ediiloupatty/buoy/perhitungan_des/chart_akurasi.png

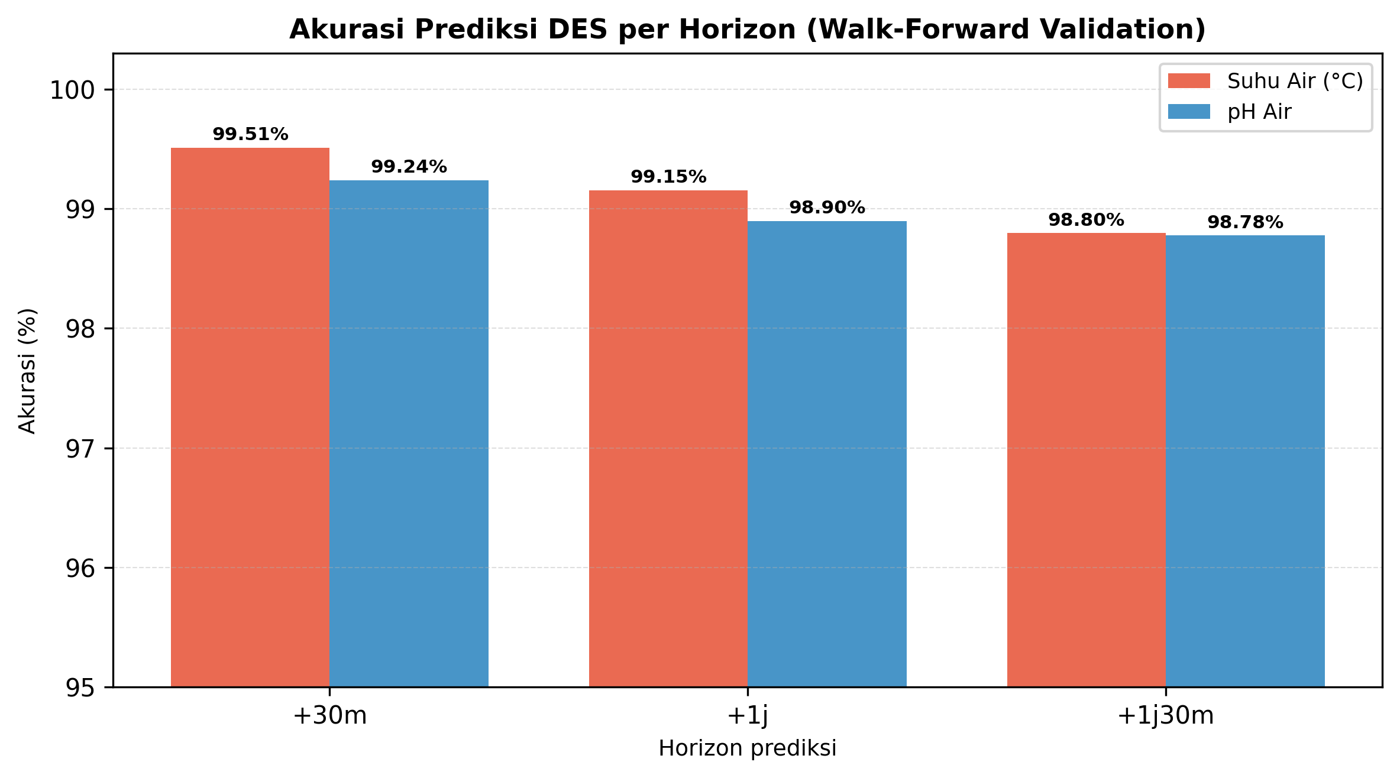
perhitungan_des/chart_akurasi.png
