ediiloupatty/buoy/perhitungan_des/chart_ph.png

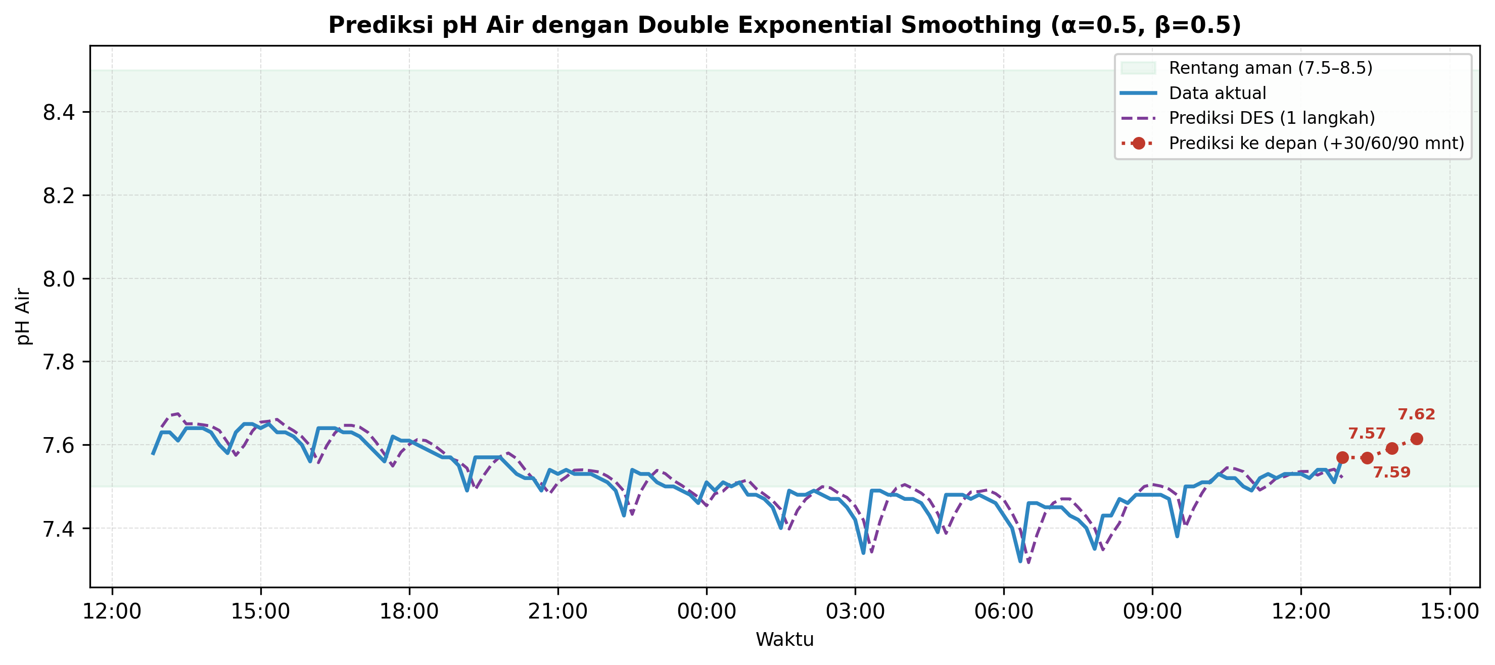
perhitungan_des/chart_ph.png
