ediiloupatty/buoy/perhitungan_des/chart_suhu.png

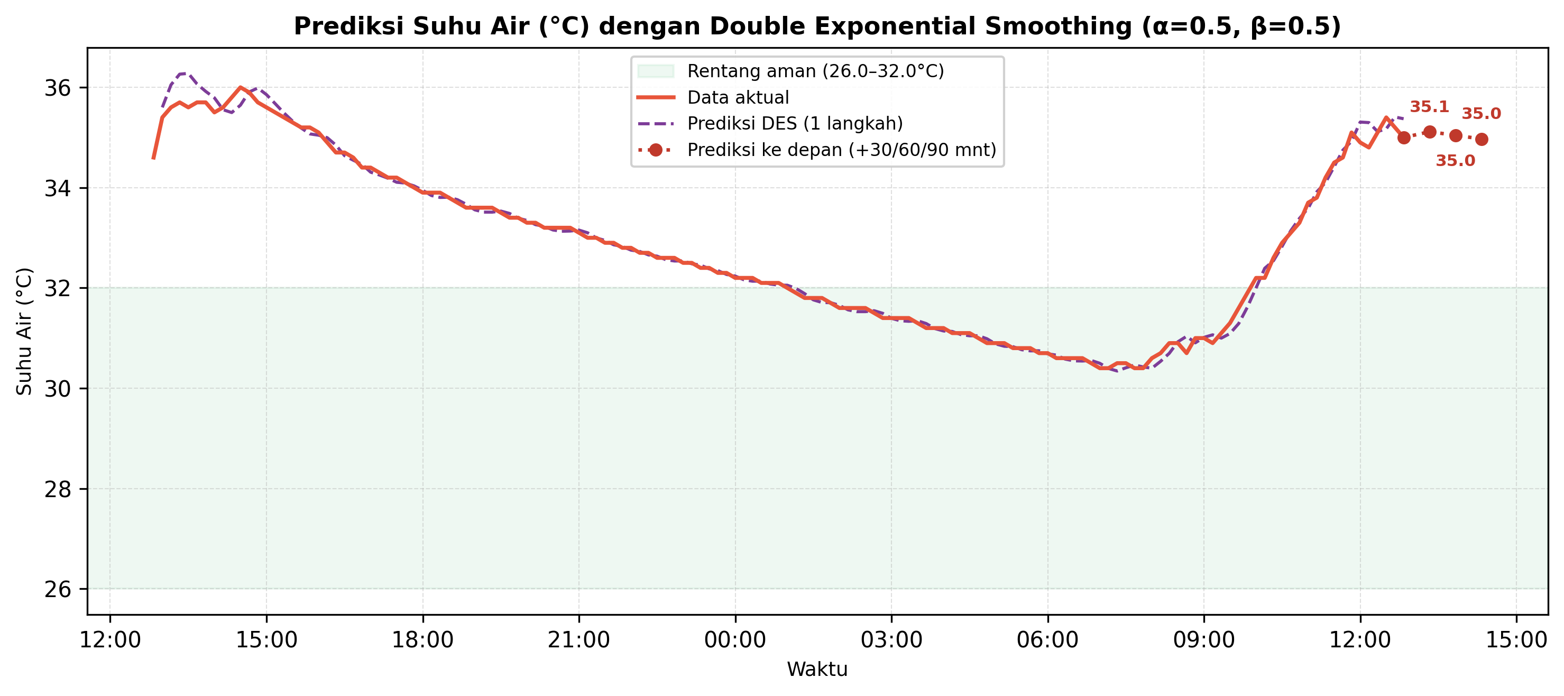
perhitungan_des/chart_suhu.png
