ediiloupatty/buoy/perhitungan_des/tuning_heatmap.png

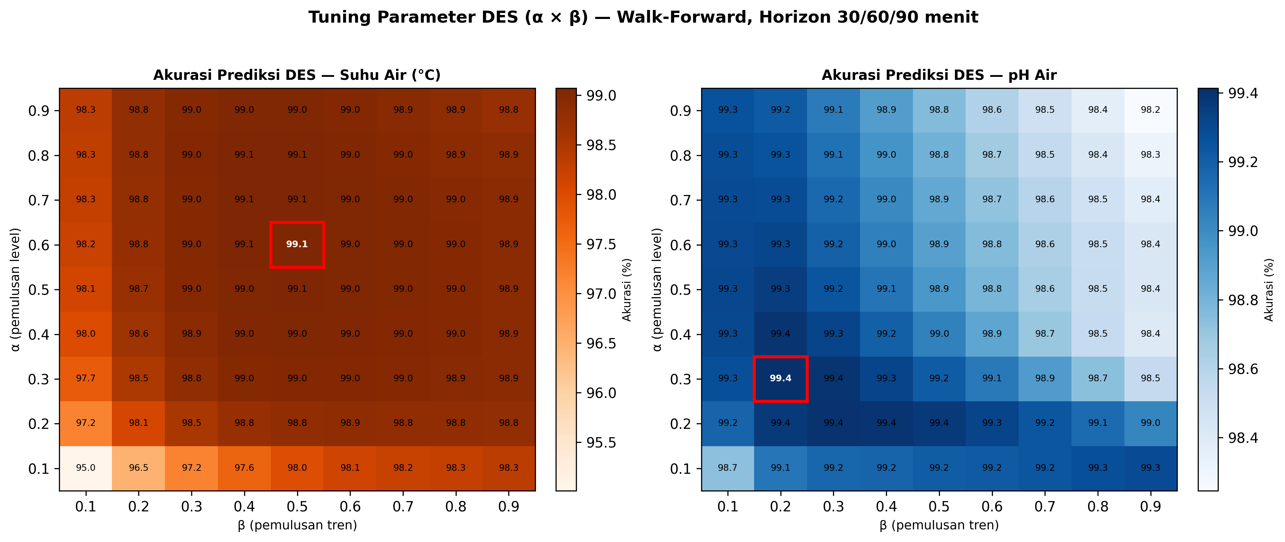
perhitungan_des/tuning_heatmap.png
