ediiloupatty/buoy/(commit log)

2026-04-18 Update web refresh and sensor reading intervals to 5 seconds
2026-04-18 Update pin labels from D to P for ESP32 dev v4
2026-04-29 perf: batch Firebase live writes into single JSON request
    - Replace 4 separate Firebase.setFloat/setInt/setString calls with 1 setJSON call
    - Reduces HTTP overhead by ~73% (from ~530MB/mo to ~145MB/mo)
    - Remove redundant status_kekeruhan from live data (derived client-side)
    - Update README documentation to reflect new data structure
    [Config.h, Sensors.cpp, final_project.ino]
2026-04-29 feat: add NTP time sync and organize Firebase history by date/time
    - Add NTP synchronization (pool.ntp.org) with WIT timezone (UTC+9)
    - History path now uses readable format: /history/2026-04-29/21:10:00
    - Fallback to millis() path if NTP sync fails (data safety)
    - Remove redundant status_kekeruhan from history data
    - Local web dashboard now shows real clock time instead of seconds-since-boot
    - Update README with new data structure docs and Flutter examples
    [final_project.ino]
2026-04-29 refactor: replace Firebase history with Supabase PostgreSQL for ML training
    - Remove Firebase /history/ writes (10min interval)
    - Add Supabase HTTP POST for history data (tabel sensor_readings)
    - Add sendToSupabase() function with NTP timestamp
    - Add Supabase URL/key placeholders in Config.h
    - Firebase now only handles live data (10sec) for Flutter app
    - Supabase handles tabular data for ML training pipeline
    - Update README with new dual-database architecture docs
    - Include SQL schema, table example, and Python ML training code
    [Config.h, final_project.ino]
2026-04-30 Refactor: Migrate history to Firebase RTDB & remove sensor smoothing
2026-04-30 Fix: Adjust NTP timezone offset to WIB (UTC+7)
    [final_project.ino]
2026-05-02 feat(sensors): add interactive pH calibration with NVS persistence and temperature compensation
    - Add Serial calibration commands (CAL4, CAL7, CALSAVE, CALINFO) for interactive two-point pH calibration
    - Persist calibration constants (m, b) to ESP32 NVS flash memory — values survive reboot
    - Add Nernst-based temperature compensation using DS18B20 data
    - Replace single-shot ADC read with trimmed mean filter (10 samples, discard 4 outliers)
    - Preserve backward-compatible readPH() signature alongside new readPH(tempC) overload
    - Read temperature before pH in main loop to ensure valid compensation data
    [Sensors.cpp, Sensors.h, final_project.ino]
2026-05-02 docs: add comprehensive pH sensor calibration guide (KALIBRASI.md)
    - Step-by-step calibration procedure (7 steps) with expected Serial output
    - Calibration theory: two-point linear, Nernst compensation, trimmed mean filter
    - Validation methodology with error percentage calculation
    - Troubleshooting table and recalibration schedule
2026-05-02 feat: migrate to SIM800L GPRS + deep sleep architecture (v2.0)
    - Replace WiFi with SIM800L GPRS via AT Commands
    - Implement ESP32 deep sleep with 2-minute wake interval
    - Remove local web server (redundant with Firebase dashboard)
    - Switch from Firebase SDK to REST API over HTTPS
    - Add RTC memory persistence for boot count and threshold values
    - Add calibration mode detection at boot (5-second serial window)
    - Add SISTEM.md comprehensive system architecture documentation
    - Update README.md to reflect v2.0 architecture
    - Energy analysis: surplus +2.36 Wh/day with deep sleep (solar sustainable)
    [Config.h, final_project.ino]
2026-05-02 refactor: separate pH calibration into standalone sketch
    - Remove calibration mode from main firmware (final_project.ino)
    - Create dedicated kalibrasi/kalibrasi.ino for pH calibration
    - Main firmware now focuses purely on: sensor → SIM800L → deep sleep
    - Both programs share the same NVS namespace ('ph_cal')
    - Added READ command in calibration tool for continuous sensor monitoring
2026-05-03 feat: add WiFi test mode for deep sleep testing
    - Add USE_WIFI conditional compilation flag in Config.h
    - WiFi credentials: SSID='No Internet Connection', PASS='Loupatty143'
    - WiFi mode uses HTTPClient + WiFiClientSecure for Firebase REST API
    - WiFi mode uses NTP (pool.ntp.org) for timestamp instead of AT+CCLK
    - All SIM800L code preserved in #else block (zero production impact)
    - Deep sleep, sensor, and RTC memory logic completely unchanged
    - To switch back to SIM800L: comment out '#define USE_WIFI' in Config.h
2026-05-07 fix(sim800l): turunkan baud rate ke 9600 dan tambah PWRKEY toggle
    - Ubah SIM_BAUD dari 115200 ke 9600 (default SIM800L, lebih stabil)
    - Tambah SIM_PWRKEY pin 5 di Config.h untuk hardware reset
    - Refactor initSIM800L(): tambah powerCycleSIM800L() dengan PWRKEY pulse
    - Tambah auto-retry: coba PWRKEY toggle jika modem tidak respons
    - Tambah AT+CMEE=2 untuk verbose error reporting saat debugging
    - Perbaiki validasi CPIN dengan 5x retry (SIM card butuh waktu init)
    - Tambah deteksi SIM PIN lock dan NO SIM sebagai error spesifik
    - Perluas timeout registrasi jaringan dari 30s ke 45s
    - Tambah info operator (AT+COPS?) di serial output untuk debug
    [Config.h, final_project.ino]
2026-05-07 fix(sim800l): ganti PWRKEY dengan RST pin (module board SIM800L)
    - Rename SIM_PWRKEY → SIM_RST di Config.h (module board pakai RST bukan PWRKEY)
    - RST active LOW: pulse LOW 200ms sudah cukup untuk reset (bukan 1200ms)
    - Rename powerCycleSIM800L() → resetSIM800L() agar lebih deskriptif
    - Update semua referensi dan pesan serial yang menyebut PWRKEY ke RST
    [Config.h, final_project.ino]
2026-05-07 fix(code-review): perbaiki 4 isu dari hasil review kode
    - Fix komentar step 3 di initSIM800L: PWRKEY → RST
    - Fix pesan error voltage: 3.7-4.2V → 4.6-5.2V (SIM800L V2)
    - Tambah header X-HTTP-Method-Override: PUT untuk sendFirebasePUT()
    karena SIM800L AT+HTTPACTION tidak support native PUT (hanya GET/POST/HEAD)
    - Perjelas komentar SLEEP_DURATION_US bahwa ini DEBUG MODE
    - Tambah dokumentasi lengkap workaround PUT di komentar sendFirebasePUT()
    [Config.h, final_project.ino]
2026-05-07 feat(diagnostic): tambah SIM800L diagnostic sketch
    - Auto-detect baud rate (coba 9600, 115200, 57600, 38400, 19200, 4800)
    - RST reset otomatis jika modem tidak respons di semua baud rate
    - Cek SIM card, sinyal, operator, dan registrasi jaringan
    - Info modem lengkap (model, firmware, IMEI)
    - Mode manual aktif setelah diagnostic — bisa ketik AT command langsung
    - Output Serial Monitor terstruktur dan mudah dibaca
2026-05-10 feat(sensor): upgrade pH calibration to 3-point piecewise linear
2026-05-10 fix: add missing ADC_FLOAT_LOW and ADC_FLOAT_HIGH constants to kalibrasi.ino
    [kalibrasi.ino]
2026-05-10 chore: update default pH calibration values to user measurements
2026-05-16 feat: migrate to 2-point pH calibration & update WiFi credentials
2026-05-16 feat: Add two-point linear calibration for Turbidity sensor
2026-05-26 feat(pump): auto-cycle 2-channel pump system (FILLING → WAITING → DRAINING)
    Migrasi firmware utama dari deep-sleep model ke always-on state machine
    yang menjalankan siklus pompa otomatis tanpa intervensi user.
    - Tambah pin relay PUMP_FILL_PIN (GPIO 25) & PUMP_DRAIN_PIN (GPIO 26)
    - State machine 3 fase: FILLING (60s) → WAITING (15s debug/15m prod) → DRAINING (40s)
    - Interlock safety: pompa 1 & 2 tidak pernah ON bersamaan
    - Mode debug/production lewat PUMP_DEBUG_MODE
    - Telemetry tiap 30s + auto-reconnect WiFi
    - Path baru /smart_buoy/pump_status untuk mobile app monitoring
    - Retry HTTP 2x untuk handshake yang gagal di jaringan lambat
    - Timestamp NTP diubah ke milliseconds (uint64_t) su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
2026-05-26 feat(sensor): hardcode turbidity 2-point + add diagnostic & accuracy testing tools
    Turbidity calibration:
    - Pindah dari NVS-based ke hardcoded constants (TURB_V_CLEAR=3.30, TURB_V_TURBID=2.26)
    - Nonaktifkan command TCAL0/TCAL400/TCALSAVE (cuma print pesan kalau dipanggil)
    - Sinkron antara Sensors.cpp dan kalibrasi.ino
    Tools baru di kalibrasi.ino:
    - CAL1 <pH> — kalibrasi 1-titik pH tanpa buffer (pertahankan slope, geser offset)
    - DIAG / DIAGTURB — sampling ADC mentah 8 detik untuk deteksi stray voltage,
    ground loop, dan riak AC dari kincir/pompa (lengkap dgn interpretasi otomatis)
    - ERRPH / ERRTURB / ERRTEMP <ref> — uji akurasi 5x pengukuran dengan tabel
    hasil (err absolut & relati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
2026-05-26 docs: tambah catatan kalibrasi, laporan uji akurasi & utilitas pendukung
    - NOTE_KALIBRASI.md: catatan resep kalibrasi DIY (turbidity & pH) + lessons learned
    - Pengujian_Akurasi_Sensor.docx: laporan tabel uji akurasi sensor (ERRPH/ERRTURB/ERRTEMP)
    - debug_turbidity/debug_turbidity.ino: sketch ESP32 standalone untuk debug sensor turbidity
    - generate_doc.py: script generator dokumentasi laporan uji
2026-06-03 feat: finalisasi scope suhu+pH, tuning siklus pompa & tambah materi perhitungan
    [data_dummy.csv, data_history.csv, data_history_24jam.csv, data_history_firebase.csv, history_2026-05-31.csv]
2026-06-07 feat: arsitektur 2-node LoRa (buoy TX + receiver gateway) + web interface + turbidity via ADS1115
    - buoy_transmitter: baca sensor + pompa + kirim LoRa (tanpa WiFi)
    - receiver_gateway: terima LoRa -> NTP -> Firebase + web monitoring di IP ESP (port 80, auto-refresh /data)
    - turbidity pindah dari ADC internal ESP32 ke ADS1115 (I2C, 16-bit) + perintah TURBV untuk re-kalibrasi
    - lora_diag: sketch diagnostik SPI Ra-02 (baca REG_VERSION)
    - Config.h per-node di-gitignore (kredensial tidak ikut)
2026-07-02 feat: node aktuator kapur + pompa (LoRa RX) beserta debug transmitter
    - node_kapur: ESP8266 + servo dispenser, dedup doseId, sync saat boot,
    clamp openMs 5 dtk, servo bergerak kecepatan penuh
    - node_pompa: ESP8266 + relay cooling, state-based + fail-safe OFF
    - debug_node_kapur_tx / debug_node_pompa_tx / debug_buoy_tx: mock TX
    untuk pengujian tiap node
    - buoy_transmitter & receiver_gateway: kirim perintah CMD ke node aktuator
    - tools/bebaskan-port.cmd + PANDUAN_NODE_AKTUATOR.pdf
    [buoy_transmitter.ino, debug_buoy_tx.ino, debug_node_kapur_tx.ino, debug_node_pompa_tx.ino, node_kapur.ino, node_pompa.ino, receiver_gateway.ino]
2026-07-02 feat: tambah Config.h node aktuator & debug TX (tanpa kredensial)
    File-file ini hanya berisi pin mapping dan parameter LoRa — tidak ada
    rahasia — dan wajib ada agar sketch bisa dikompilasi dari clone baru.
